eejhongxin/Collect-temperature-and-humidity-display-and-cloud-data-storage/README.md

# Collect-temperature-and-humidity-display-and-cloud-data-storage
设计一个温湿度检测和控制的单片机系统，能够自动检测出当前情况的温度和湿度数值并且实时上传到onenet云平台进行数据存储和可视化显示。在使用过程中，用户可以自己设置温湿度系统的温度上下限和湿度上下限，当单片机检测用户设置的上下限时，会自动启动继电器带动工作电器对其进行降温操作。
