eejhongxin/Collect-temperature-and-humidity-display-and-cloud-data-storage/程序清单/miniprogram-1/pages/iamge/温度计.png

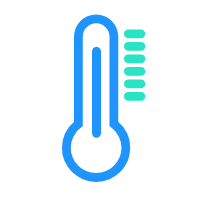
程序清单/miniprogram-1/pages/iamge/温度计.png
