eejhongxin/Collect-temperature-and-humidity-display-and-cloud-data-storage/(list of files, cad)

Other CAD files:
程序清单/单片机系统设计/main.OBJ
程序清单/单片机系统设计/STARTUP.OBJ
程序清单/单片机系统设计/showtemperature.OBJ
程序清单/单片机系统设计/wifi_control.OBJ
程序清单/单片机系统设计/uart.OBJ
程序清单/单片机系统设计/delay.OBJ
程序清单/单片机系统设计/ired.OBJ
程序清单/单片机系统设计/IIc.OBJ
程序清单/单片机系统设计/key.OBJ
程序清单/单片机系统设计/dht11.OBJ
程序清单/单片机系统设计/12864.OBJ
