eejhongxin/Collect-temperature-and-humidity-display-and-cloud-data-storage/程序清单/单片机系统设计/showtemperature.h

#ifndef __SHOWTEMPERATURE_H__
#define __SHOWTEMPERATURE_H__

extern uchar wendu[4];
extern uchar shidu[4];
extern uchar temtop[4];
extern uchar temlow[4];
extern uchar humtop[4];
extern uchar humlow[4];
extern uint ttop,tlow,htop,hlow,tnow,hnow;
extern uchar i;
void showtem();
void settem();
void detect();
#endif
